christoph-krionx/UFC/README.md

# UFC – configurable MIDI foot controller

A MIDI foot controller for guitarists, built around an Arduino Mega 2560 Pro.
Every switch can send program changes and control changes to amps, modellers and effects.
The assignment is edited on the device itself or with a web editor over USB.

The same board and firmware are used in two builds:

| Variant | `BOARD` | Switches | LEDs | Display | Pages |
| --- | --- | --- | --- | --- | --- |
| UFC | `1` (default) | 21 foot switches, 4 external switches | 2 per switch | 20x2 LCD with edit mode | 1 |
| Stomp6 | `2` | 6 foot switches | 1 per switch | 20x2 LCD with the switch names, configured with the web editor | 2 (scenes, pedalboard) |

## Hardware

Board **UFC rev. 1** (KiCad 10 project in `hardware/UFC`, schematic as [PDF](hardware/UFC/UFC.pdf)):

- RobotDyn Mega 2560 Pro (ATmega2560, CH340 USB serial)
- 21 foot switches in four rows (3 + 6 + 6 + 6), each with two WS2812 LEDs
- 4 inputs for external switches, 2 inputs for expression pedals
- 20x2 character LCD (HD44780)
- 2 MIDI inputs and 2 MIDI outputs (5 pin DIN)

### Board revisions

| Revision | Date | Git tag | Notes |
| --- | --- | --- | --- |
| rev. 1 | 2026-10-12 | `hw-rev1` | LCD pin 5 (R/W) connected to GND |
| rev. 0 | 2018-10-05 | `hw-rev0` | manufactured, has a known error (see below) |

**Known error of rev. 0:** pin 5 (R/W) of the LCD is connected to +5 V instead of GND.
The display stays in read mode and shows nothing.
Rework for existing boards: cut the connection between pin 5 and +5 V at the display connector and connect pin 5 to GND, for example to pin 1.

The firmware runs on both revisions without changes.
The fabrication files of rev. 1 are in `hardware/UFC/Gerber`, those of rev. 0 in `hardware/UFC/Gerber/rev00`.

### Pin assignment

The firmware takes the mapping from `firmware/ufc/Board.h`.

| Function | Arduino pin | Connector | Notes |
| --- | --- | --- | --- |
| LCD RS / EN | D5 / D7 | DISP1 | 4 bit mode, R/W tied to GND (rev. 0: see board revisions) |
| LCD DB4 – DB7 | D9, D11, D13, D15 | DISP1 | contrast set with trimmer RV1 |
| LED data | D6 | J22 | WS2812 chain, 220 Ω in series |
| LED power enable | D12 | – | active low, switches the LED supply |
| MIDI 1 out / in | D18 (TX1) / D19 (RX1) | J23 / J25 | `Serial1`, input with optocoupler |
| MIDI 2 out / in | D16 (TX2) / D17 (RX2) | J24 / J26 | `Serial2`, input with optocoupler |
| Expression pedal 1 / 2 | A0 / A1 | J27 / J28 | AREF is driven externally, the firmware has to use `analogReference(EXTERNAL)` |
| External switch 1 / 2 | D21 / D22 | J29 | active low |
| External switch 3 / 4 | D23 / D24 | J30 | active low |
| USB serial (editor, upload) | D0 / D1 | USB | CH340 on the Mega 2560 Pro |
| Supply | VIN / 5V | J32 / J31 | |

Unused pins: D2, D3, D4, D8, D10, D14, D20, D25 – D32, A2 – A15.

### Foot switches and LEDs

The switches are numbered from bottom left to top right as seen by the player.
All switch inputs are active low with a 10 kΩ pull-up and 100 nF on the board.
The LED chain starts at switch 19 and snakes down row by row, the table shows the position of the left and right LED in the chain (0 – 41).

| Row | Switch | Arduino pin | Connector | LED left / right |
| --- | --- | --- | --- | --- |
| 4 (top) | 19 | D51 | J1 | 0 / 1 |
| | 20 | D49 | J2 | 2 / 3 |
| | 21 | D45 | J3 | 4 / 5 |
| 3 | 13 | D40 | J9 | 17 / 16 |
| | 14 | D37 | J8 | 15 / 14 |
| | 15 | D35 | J7 | 13 / 12 |
| | 16 | D33 | J6 | 11 / 10 |
| | 17 | D41 | J5 | 9 / 8 |
| | 18 | D44 | J4 | 7 / 6 |
| 2 | 7 | D39 | J10 | 18 / 19 |
| | 8 | D52 | J11 | 20 / 21 |
| | 9 | D50 | J12 | 22 / 23 |
| | 10 | D48 | J13 | 24 / 25 |
| | 11 | D47 | J14 | 26 / 27 |
| | 12 | D42 | J15 | 28 / 29 |
| 1 (bottom) | 1 | D53 | J21 | 41 / 40 |
| | 2 | D46 | J20 | 39 / 38 |
| | 3 | D43 | J19 | 37 / 36 |
| | 4 | D38 | J18 | 35 / 34 |
| | 5 | D36 | J17 | 33 / 32 |
| | 6 | D34 | J16 | 31 / 30 |

### Stomp6 variant

Six foot switches in two rows of three, one WS2812 LED per switch.
The 20x2 LCD (Fordata FC2002C, same connection as on the UFC) sits between the rows.
MIDI 1 has input and output, MIDI 2 only the output.
The mapping is in `firmware/ufc/Board_Stomp6.h`.
The LED chain starts at switch 3 (bottom right), runs to the left and back through the top row.

| Row | Switch | Arduino pin | Connector | LED |
| --- | --- | --- | --- | --- |
| top | 4 | D35 | J7 | 3 |
| | 5 | D33 | J6 | 4 |
| | 6 | D41 | J5 | 5 |
| bottom | 1 | D44 | J4 | 2 |
| | 2 | D45 | J3 | 1 |
| | 3 | D49 | J2 | 0 |

## Repository

| Folder | Content |
| --- | --- |
| `firmware/ufc` | controller firmware |
| `firmware/ufc_hwtest` | stand-alone hardware test |
| `editor` | web editor (plain HTML and JavaScript, no build step) |
| `hardware/UFC` | schematic, layout, project libraries and Gerber files |

## Firmware

Features of the current version:

- 8 presets with names, the last used preset is restored after power on
- up to 3 messages per switch (Stomp6: 5), program change or control change, each with MIDI output and channel
- switch modes: toggle, momentary and group (only one switch of the group on the same page is active)
- global switches which keep their function in every preset, for example preset up / down or tuner; on boards with pages a switch is global per page (Stomp6: a global pedalboard block, the scene at the same place stays per preset)
- messages which are sent when a preset is loaded
- pages: every preset has its own switch assignment per page (Stomp6: page 1 scenes, page 2 pedalboard)
- links: a switch sets the switches of the last page on or off when it is switched on, the LEDs follow (Stomp6: a scene sets the pedalboard blocks)
- actions: long press of a switch or two switches pressed together, for example tuner, preset up / down or page change; a switch with an action reacts on release
- Stomp6 display: line 1 shows the names of the top row, line 2 the names of the bottom row, each name above / below its switch; the names follow the page.
  Preset number, name and tempo, the page name and the tap tempo are shown in line 1 for 1.5 s, the name of an active MIDI action (for example `TUNER`) replaces line 1 while the action is on
  If the top left and the top middle switch have no function or no name, line 1 keeps showing preset number and name (with the tempo if the top right switch is free too)
- optional pause after a program change, optionally a program change is only sent if it differs from the last one on the channel
- MIDI clock with a tempo per preset (0: no clock until tapped), tap tempo on a switch with the function "Tap" or on the active group switch pressed again, the tap switch flashes in time
- configuration stored in the internal EEPROM, every block protected by a checksum; a configuration of the other variant or an older format is replaced by the factory configuration

### Build and upload

The firmware is a plain Arduino sketch. Required libraries: FastLED and LiquidCrystal.

```bash
arduino-cli compile --fqbn arduino:avr:mega firmware/ufc
```

```bash
arduino-cli upload --fqbn arduino:avr:mega -p <port> firmware/ufc
```

The Stomp6 variant is selected with `BOARD=2`, compile and upload in one step:

```bash
arduino-cli compile --fqbn arduino:avr:mega --build-property "build.extra_flags=-DBOARD=2" --upload -p <port> firmware/ufc
```

The Arduino IDE works as well: open `firmware/ufc/ufc.ino` and select the board "Arduino Mega or Mega 2560".
For the Stomp6 variant change the default of `BOARD` in `firmware/ufc/Board.h`.

### Stomp6 with a Sonulab StompStation PRO

The factory configuration of the Stomp6 variant is made for the StompStation PRO on MIDI channel 1 (StompStation: Setting, Misc, MIDI Address 0).
The StompStation has a 3.5 mm TRS jack, the MIDI cable needs a **Type A** adapter.

| Gesture | Function |
| --- | --- |
| switch 1 – 6 | scene (page 1) or block on / off (page 2) |
| active scene again | tap tempo, the scene flashes in time while the MIDI clock runs |
| hold switch 1 | tuner on / off (CC 11), switch 1 lights red while it is on |
| hold switch 6 | change between scenes and pedalboard |
| switch 1 + 2 | previous preset |
| switch 2 + 3 | next preset |

All presets are empty, the scenes are assigned in the editor.
The pedalboard is global with Drive (CC 1), Comp (CC 8), Wah (CC 14), Mod post (CC 6), Delay (CC 10) and Reverb (CC 5).
The actions above and tap tempo on the active scene are part of the factory configuration.
Delay and modulation of the StompStation follow the MIDI clock if they are locked to the global tempo.

A setup used with the StompStation: presets 1 – 6 are one main sound each, the start message of the preset sends PC 0 – 5.
The scenes (for example rhythm, solo, clean) send the same program change and set all six pedalboard blocks, so the LEDs always show the real state.
Useful fixed control changes of the StompStation:

| CC | Block | CC | Block |
| --- | --- | --- | --- |
| 1 | Drive | 9 | Gate |
| 2 | Mod pre | 10 | Delay 1 |
| 3 | Amp | 11 | Tuner |
| 4 | IR | 12 | Expr |
| 5 | Reverb | 13 | Expr Boost |
| 6 | Mod post | 14 | Wah |
| 7 | Tremolo | 15 | EQ |
| 8 | Comp | 16 | Pitch |

Values 0 – 63 switch a block off, 64 – 127 on. CC 20 is the global volume, CC 21 / 22 select the next / previous preset.
Other parameters are reached with the assignable controllers 1 – 3 of the StompStation (CC 32 – 127).

Tested behaviour of the StompStation (firmware of October 2026):

- a program change switches presets without asking, unsaved changes of the active preset are discarded
- a control change sent directly after a program change is applied
- the program change of the active preset loads it again, switching within a bank of three is gapless
- CC 21 / 22 select the next / previous preset (the troubleshooting chapter of the manual names CC 12 / 13 by mistake)
- the StompStation sends no state, the controller cannot know changes made on the pedal itself

### Edit mode on the device

Hold switch 19 and 20 (top row) for one second. The bottom row then works as keys:

| Switch | Function |
| --- | --- |
| 1 / 2 | previous / next field |
| 3 / 4 | value down / up, hold to repeat |
| 5 | back, unsaved changes are discarded |
| 6 | save |

Stepping on any other switch selects it for editing.

Holding switch 19 and 21 during power on restores the factory configuration (Stomp6: switch 4 and 6).
The Stomp6 variant has no edit mode.

## Web editor

The editor talks to the controller with the Web Serial API and therefore needs Chrome or Edge on a desktop computer.

```bash
python -m http.server 8137 --bind 127.0.0.1 --directory editor
```

Open `http://localhost:8137`, connect and select the serial port of the controller.
The configuration can also be saved to and loaded from a file.
The editor adapts to the connected variant, pages are selected above the switches, actions and the program change options are under "Global".
Files of older firmware versions (0.3 and later) can be loaded: values the file does not have are taken from the connected device or set to defaults, a switch that was global keeps its global definition on every page, actions get an empty name.
A file of the other variant (different number of switches) is rejected.

The serial protocol is described in `firmware/ufc/Protocol.h`, the data format in `firmware/ufc/Config.h` and `firmware/ufc/Storage.h`.

## Hardware test

`firmware/ufc_hwtest` checks display, LEDs, switches and both MIDI ports and shows the result on the display.
The MIDI test needs a DIN cable from each output to an input.

## License

MIT, see [LICENSE](LICENSE).
