christoph-krionx/UFC/hardware/UFC/UFC.pdf

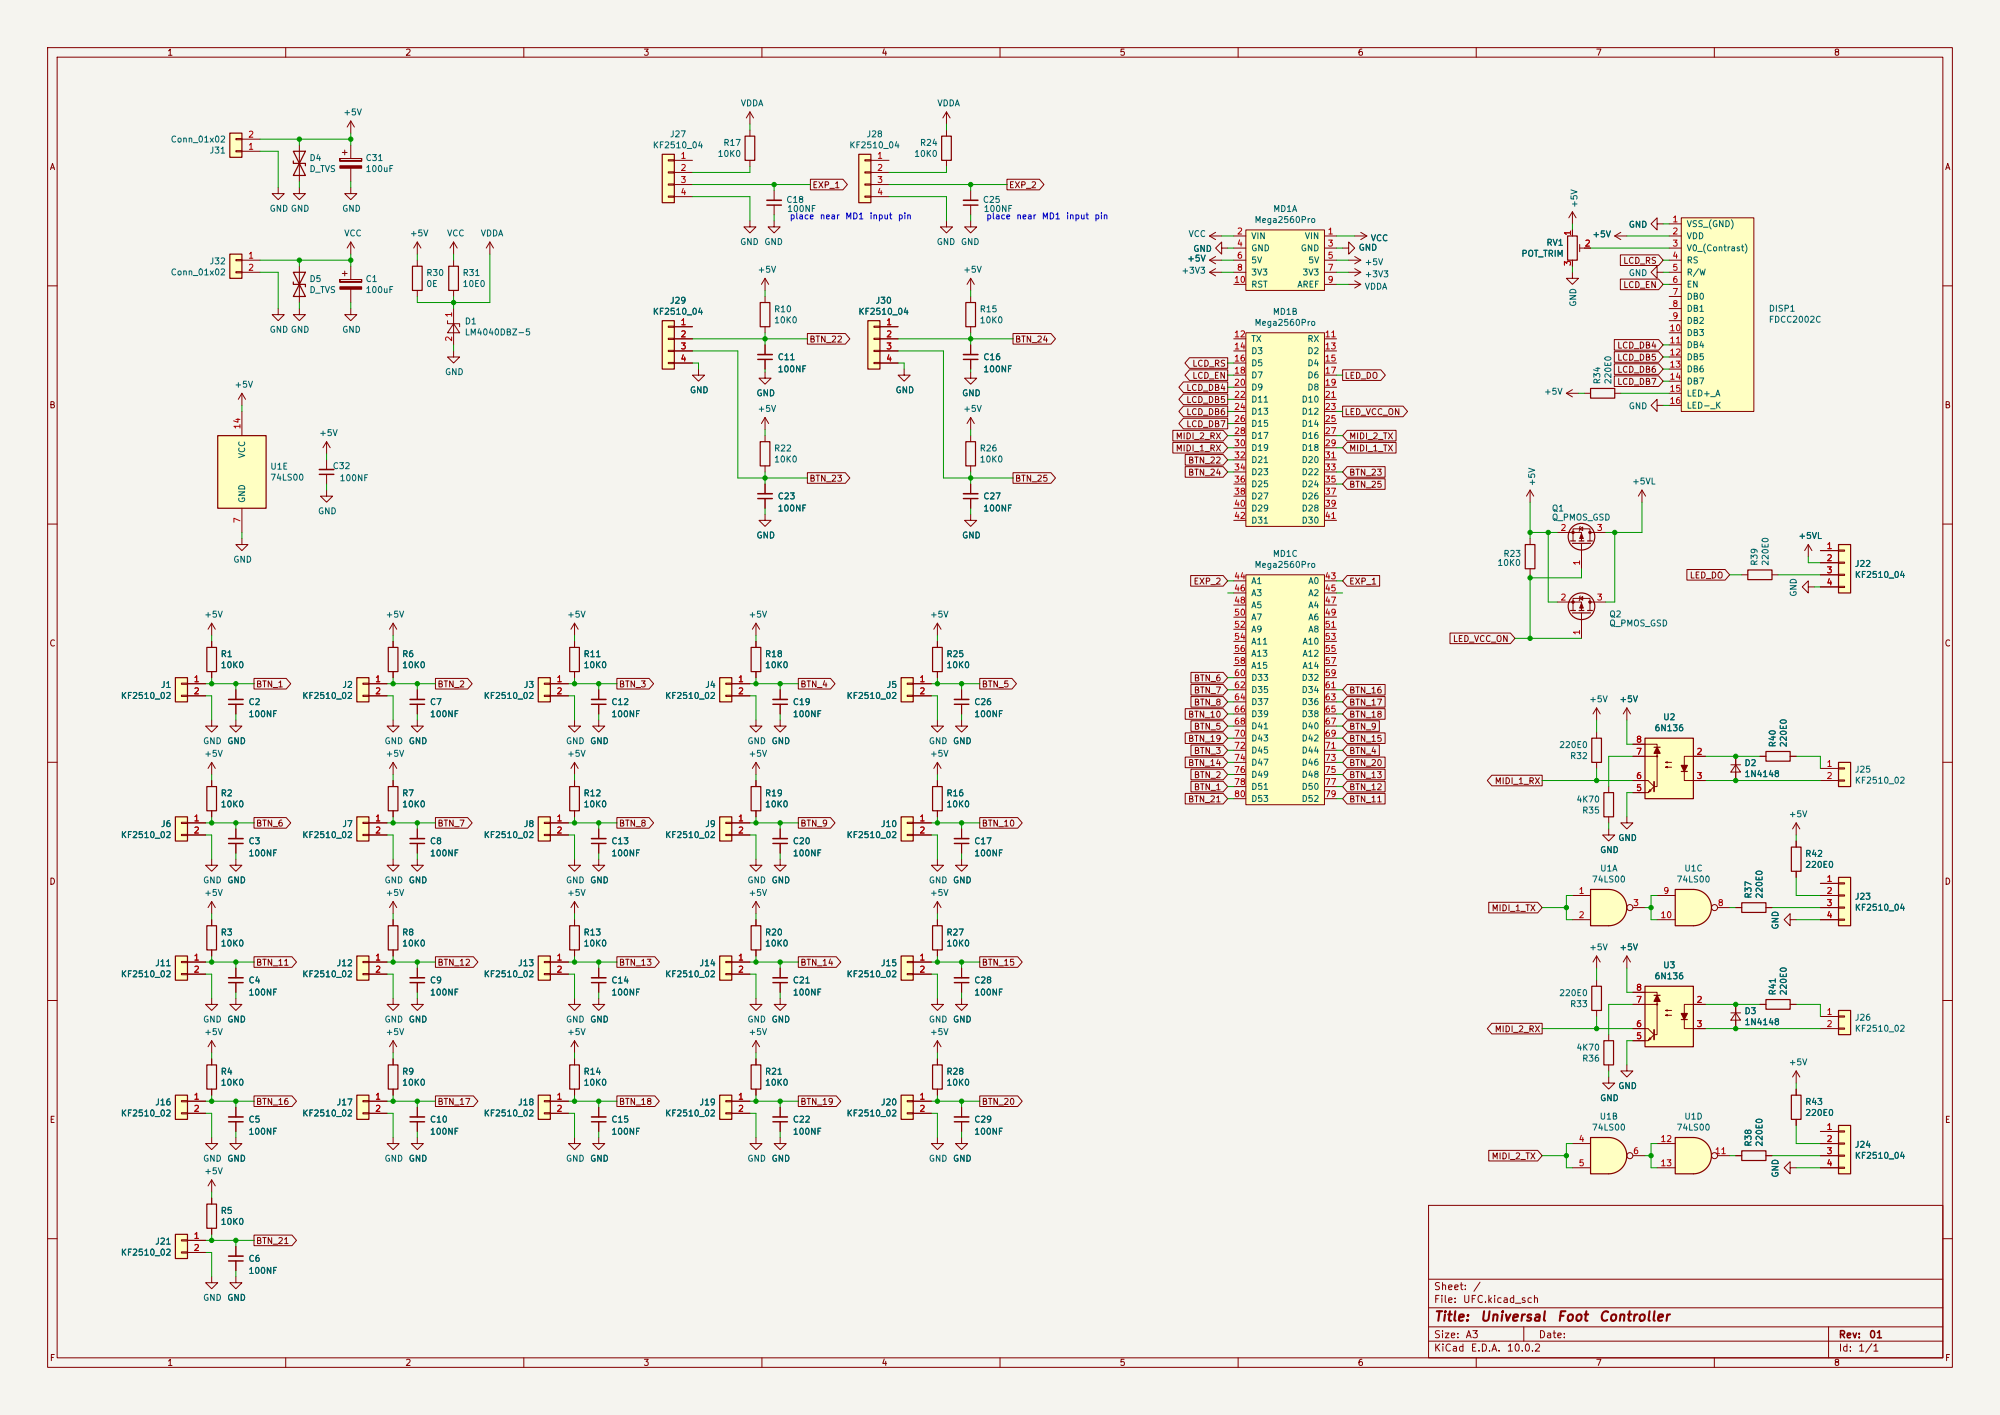
[picture p1: page 1]

Sheet: /
File: UFC.kicad_sch
Title: Universal Foot Controller

Size: A3 | Rev: 01 | F Date:
KiCad E.D.A. 10.0.2 | Id: 1/1
