christoph-krionx/UFC/hardware/UFC/UFC.kicad_pcb

## KiCad design hardware/UFC/UFC.kicad_pcb (2026-10-12)

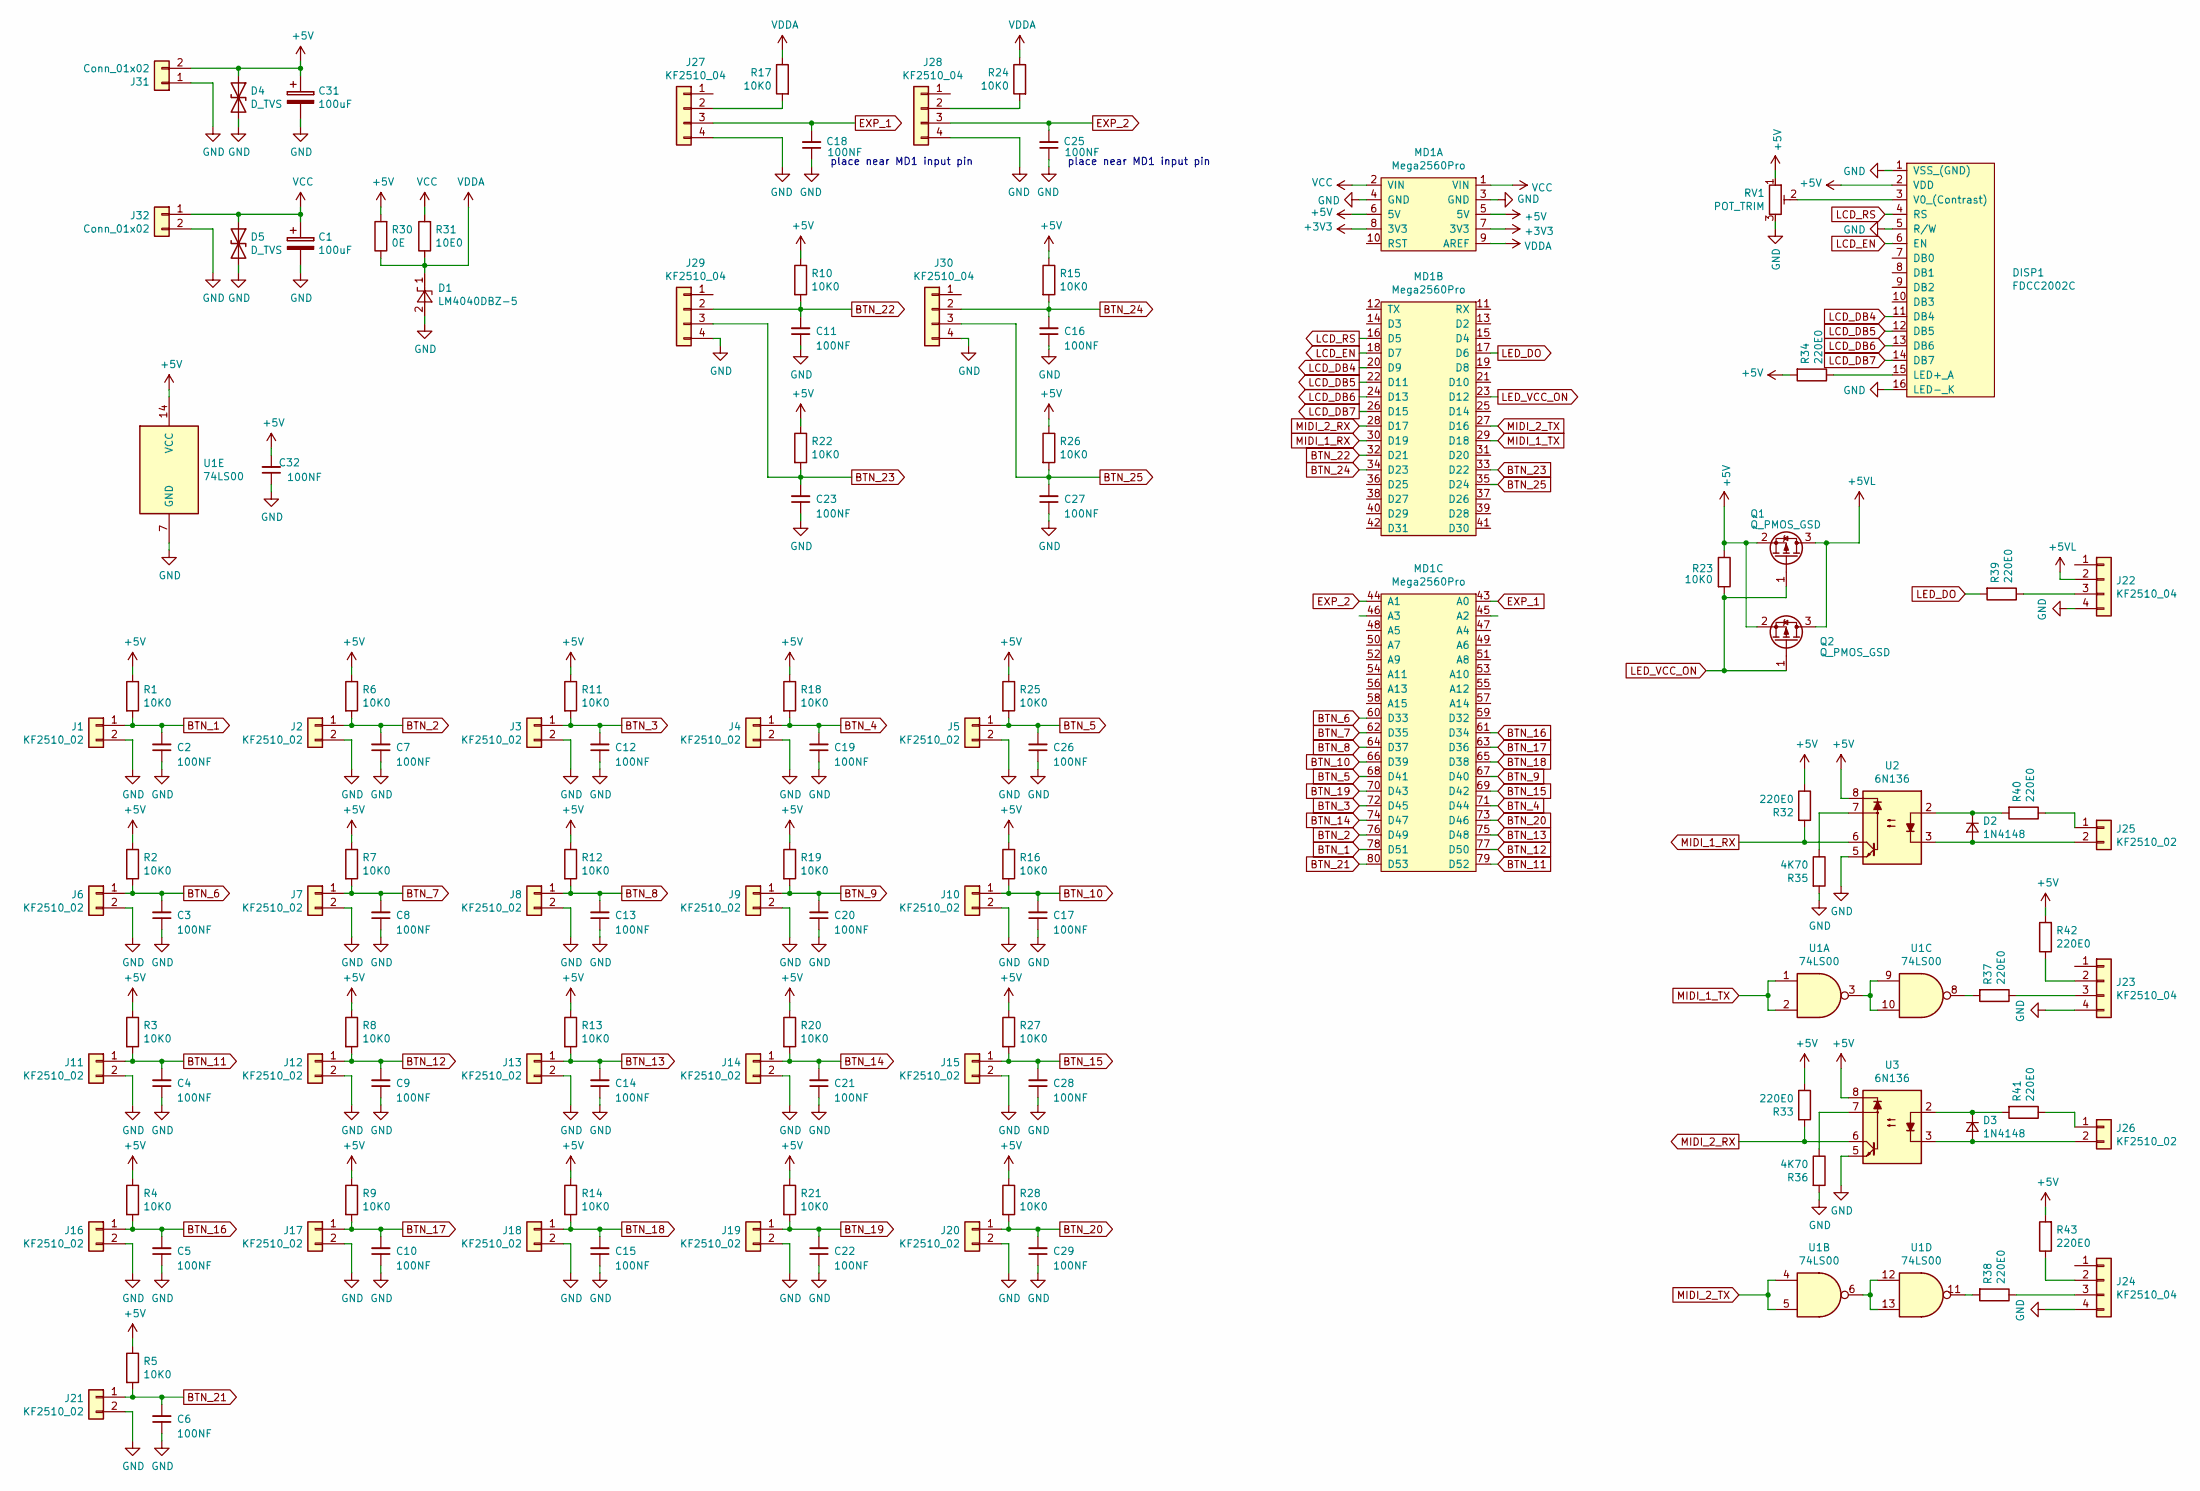
[picture p2: schematic UFC.kicad_sch, Universal Foot Controller]

Parts:
C1, C31: 100uF; CP_Radial_D10.0mm_P5.00mm
C2, C3, C4, C5, C6, C7, C8, C9, C10, C11, C12, C13, C14, C15, C16, C17, C18, C19, C20, C21, C22, C23, C25, C26, C27, C28, C29, C32: 100NF; C_0805_2012Metric_Pad1.29x1.40mm_HandSolder
D1: LM4040DBZ-5; SOT-23
D2, D3: 1N4148; D_DO-41_SOD81_P7.62mm_Horizontal
D4, D5: D_TVS; D_SMA_Handsoldering
DISP1: FDCC2002C
J1, J2, J3, J4, J5, J6, J7, J8, J9, J10, J11, J12, J13, J14, J15, J16, J17, J18, J19, J20, J21, J25, J26: KF2510_02; Molex_KK-254_AE-6410-02A_1x02_P2.54mm_Vertical
J22, J23, J24, J27, J28, J29, J30: KF2510_04; Molex_KK-254_AE-6410-04A_1x04_P2.54mm_Vertical
J31, J32: Conn_01x02; TerminalBlock_Phoenix_PT-1,5-2-3.5-H_1x02_P3.50mm_Horizontal
MD1: Mega2560Pro; Mega2560Core
Q1, Q2: Q_PMOS_GSD; SOT-23_Handsoldering
R1, R2, R3, R4, R5, R6, R7, R8, R9, R10, R11, R12, R13, R14, R15, R16, R17, R18, R19, R20, R21, R22, R23, R24, R25, R26, R27, R28: 10K0; R_0805_2012Metric_Pad1.29x1.40mm_HandSolder
R30: 0E; R_0805_2012Metric_Pad1.29x1.40mm_HandSolder
R31: 10E0; R_0805_2012Metric_Pad1.29x1.40mm_HandSolder
R32, R33, R37, R38, R39, R40, R41, R42, R43: 220E0; R_0805_2012Metric_Pad1.29x1.40mm_HandSolder
R34: 220E0; R_1206_3216Metric_Pad1.39x1.80mm_HandSolder
R35, R36: 4K70; R_0805_2012Metric_Pad1.29x1.40mm_HandSolder
RV1: POT_TRIM; Potentiometer_Trimmer_Vishay_TS53YJ
U1: 74LS00; DIP-14_W7.62mm
U2, U3: 6N136; SMD-8

Connections:
+3V3: MD1.7 (3V3), MD1.8 (3V3)
+5V: C31.1, C32.2, D4.1 (A1), DISP1.2 (VDD), J31.2, MD1.5 (5V), MD1.6 (5V), Q1.2 (S), Q2.2 (S), R1.1, R2.1, R3.1, R4.1, R5.1, R6.1, R7.1, R8.1, R9.1, R10.1, R11.1, R12.1, R13.1, R14.1, R15.1, R16.1, R18.1, R19.1, R20.1, R21.1, R22.1, R23.1, R25.1, R26.1, R27.1, R28.1, R30.2, R32.1, R33.1, R34.2, R42.2, R43.2, RV1.1, U1.14 (VCC), U2.8, U3.8
+5VL: J22.2, Q1.3 (D), Q2.3 (D)
BTN_1: C2.2, J1.1, MD1.78 (D51), R1.2
BTN_2: C7.2, J2.1, MD1.76 (D49), R6.2
BTN_3: C12.2, J3.1, MD1.72 (D45), R11.2
BTN_4: C19.2, J4.1, MD1.71 (D44), R18.2
BTN_5: C26.2, J5.1, MD1.68 (D41), R25.2
BTN_6: C3.2, J6.1, MD1.60 (D33), R2.2
BTN_7: C8.2, J7.1, MD1.62 (D35), R7.2
BTN_8: C13.2, J8.1, MD1.64 (D37), R12.2
BTN_9: C20.2, J9.1, MD1.67 (D40), R19.2
BTN_10: C17.2, J10.1, MD1.66 (D39), R16.2
BTN_11: C4.2, J11.1, MD1.79 (D52), R3.2
BTN_12: C9.2, J12.1, MD1.77 (D50), R8.2
BTN_13: C14.2, J13.1, MD1.75 (D48), R13.2
BTN_14: C21.2, J14.1, MD1.74 (D47), R20.2
BTN_15: C28.2, J15.1, MD1.69 (D42), R27.2
BTN_16: C5.2, J16.1, MD1.61 (D34), R4.2
BTN_17: C10.2, J17.1, MD1.63 (D36), R9.2
BTN_18: C15.2, J18.1, MD1.65 (D38), R14.2
BTN_19: C22.2, J19.1, MD1.70 (D43), R21.2
BTN_20: C29.2, J20.1, MD1.73 (D46), R28.2
BTN_21: C6.2, J21.1, MD1.80 (D53), R5.2
BTN_22: C11.2, J29.2, MD1.32 (D21), R10.2
BTN_23: C23.2, J29.3, MD1.33 (D22), R22.2
BTN_24: C16.2, J30.2, MD1.34 (D23), R15.2
BTN_25: C27.2, J30.3, MD1.35 (D24), R26.2
EXP_1: C18.2, J27.3, MD1.43 (A0)
EXP_2: C25.2, J28.3, MD1.44 (A1)
GND: C1.2, C2.1, C3.1, C4.1, C5.1, C6.1, C7.1, C8.1, C9.1, C10.1, C11.1, C12.1, C13.1, C14.1, C15.1, C16.1, C17.1, C18.1, C19.1, C20.1, C21.1, C22.1, C23.1, C25.1, C26.1, C27.1, C28.1, C29.1, C31.2, C32.1, D1.2 (A), D4.2 (A2), D5.2 (A2), DISP1.1 (VSS_(GND)), DISP1.5 (R/W), DISP1.16 (LED-_K), J1.2, J2.2, J3.2, J4.2, J5.2, J6.2, J7.2, J8.2, J9.2, J10.2, J11.2, J12.2, J13.2, J14.2, J15.2, J16.2, J17.2, J18.2, J19.2, J20.2, J21.2, J22.4, J23.4, J24.4, J27.4, J28.4, J29.4, J30.4, J31.1, J32.2, MD1.3 (GND), MD1.4 (GND), R35.2, R36.2, RV1.3, U1.7 (GND), U2.5, U3.5
LCD_DB4: DISP1.11 (DB4), MD1.20 (D9)
LCD_DB5: DISP1.12 (DB5), MD1.22 (D11)
LCD_DB6: DISP1.13 (DB6), MD1.24 (D13)
LCD_DB7: DISP1.14 (DB7), MD1.26 (D15)
LCD_EN: DISP1.6 (EN), MD1.18 (D7)
LCD_RS: DISP1.4 (RS), MD1.16 (D5)
LED_DO: MD1.17 (D6), R39.2
LED_VCC_ON: MD1.23 (D12), Q1.1 (G), Q2.1 (G), R23.2
MIDI_1_RX: MD1.30 (D19), R32.2, U2.6
MIDI_1_TX: MD1.29 (D18), U1.1, U1.2
MIDI_2_RX: MD1.28 (D17), R33.2, U3.6
MIDI_2_TX: MD1.27 (D16), U1.4, U1.5
unnamed: D2.2 (A), J25.2, U2.3
unnamed: D2.1 (K), R40.2, U2.2
unnamed: D3.2 (A), J26.2, U3.3
unnamed: D3.1 (K), R41.2, U3.2
unnamed: DISP1.15 (LED+_A), R34.1
unnamed: DISP1.3 (V0_(Contrast)), RV1.2
unnamed: J22.3, R39.1
unnamed: J23.2, R42.1
unnamed: J23.3, R37.1
unnamed: J24.2, R43.1
unnamed: J24.3, R38.1
unnamed: J25.1, R40.1
unnamed: J26.1, R41.1
unnamed: J27.2, R17.2
unnamed: J28.2, R24.2
unnamed: R35.1, U2.7
unnamed: R36.1, U3.7
unnamed: R37.2, U1.8
unnamed: R38.2, U1.11
unnamed: U1.3, U1.9, U1.10
unnamed: U1.6, U1.12, U1.13
VCC: C1.1, D5.1 (A1), J32.1, MD1.1 (VIN), MD1.2 (VIN), R31.2
VDDA: D1.1 (K), MD1.9 (AREF), R17.1, R24.1, R30.1, R31.1

Notes on the sheet:
place near MD1 input pin

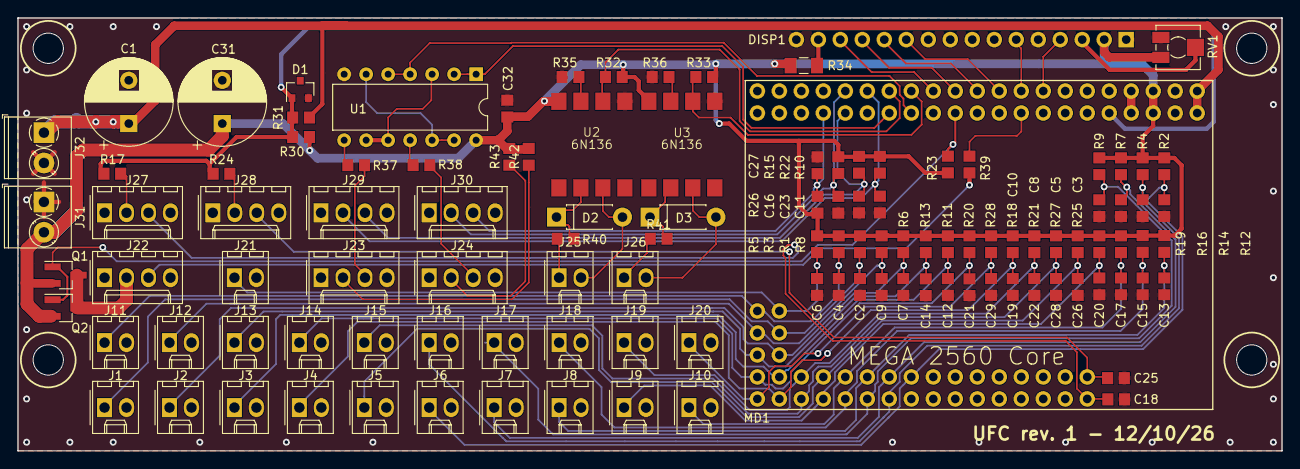
[picture p3: board UFC.kicad_pcb from above]

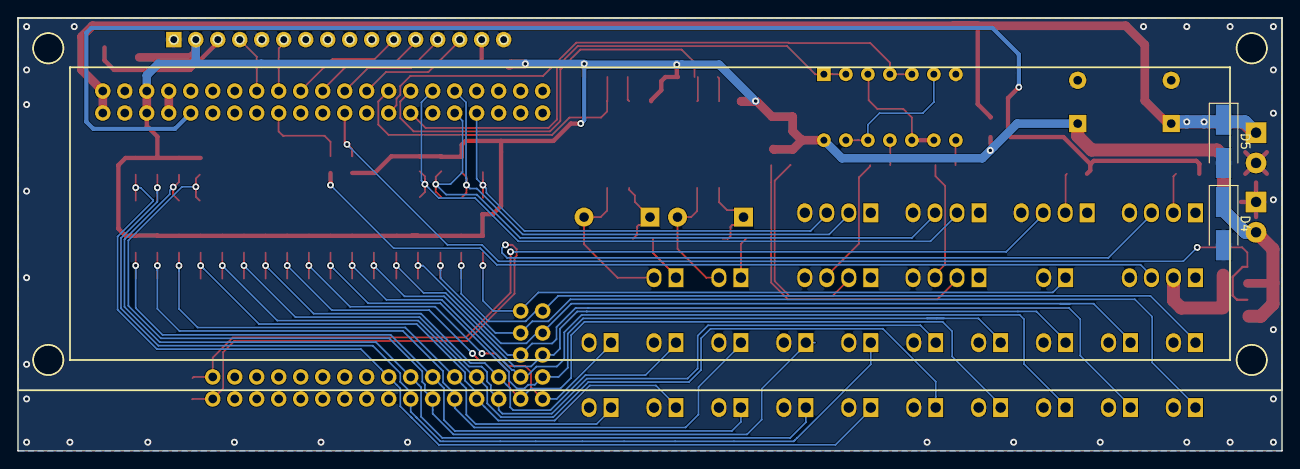
[picture p4: board UFC.kicad_pcb from below]

Board: 2 copper layers, 146.0 x 50.0 mm, 117 parts (2 on the bottom side), 66 nets.
