christoph-krionx/UFC/(commit log)

2026-10-11 Initial commit: UFC configurable MIDI foot controller
    Firmware, hardware test and web editor for the UFC rev. 0 board.
2026-10-11 Document the pin assignment in the README
2026-10-11 Add the KiCad project of the UFC rev. 0 board
    Schematic, layout and Gerber files. All symbols and footprints are kept in
    project libraries, so the project does not depend on the installed KiCad libraries.
    [UFC-B.Cu.gbl, UFC-B.Fab.gbr, UFC-B.Mask.gbs, UFC-Edge.Cuts.gm1, UFC-F.Cu.gtl, UFC-F.Fab.gbr, UFC-F.Mask.gts, UFC-NPTH-drl_map.gbr]
2026-10-12 Board rev. 1: connect LCD pin 5 (R/W) to GND
    On rev. 0 the pin was connected to +5V, the display stayed in read mode.
    The fabrication files of rev. 0 are kept in Gerber/rev00, the README lists
    the revisions and the rework for existing boards.
    [UFC-B.Cu.gbl, UFC-B.Fab.gbr, UFC-B.Mask.gbs, UFC-B_Cu.gbl, UFC-B_Mask.gbs, UFC-B_Paste.gbp, UFC-B_Silkscreen.gbo, UFC-Edge.Cuts.gm1]
2026-10-31 Firmware 0.4.0: Stomp6 board variant, pages, scenes and actions
    The UFC board is also used with only 6 foot switches, one LED each and
    no display. The variant is selected at compile time with BOARD=2.
    - board definitions split into Board_UFC21.h and Board_Stomp6.h
    - pages: a preset has its own switch assignment per page
    - links: a switch sets the switches of the last page on / off (scenes
    set the pedalboard blocks)
    - actions: long press or two switches together, e.g. tuner, preset
    up / down, page change
    - optional pause after a program change and option to skip a program
    change equal to the last one
    - debounce accepts a switch state only after it is stable for 20 ms,
    a bouncing rele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
    [Board.h, Board_Stomp6.h, Board_UFC21.h, Config.h, Controller.cpp, Controller.h, Display.cpp, Display.h]
2026-11-01 Firmware 0.5.0: tap tempo and MIDI clock
    - tempo per preset, the controller sends MIDI clock (24 ticks per
    quarter note) while a tempo is set or after tapping
    - tap tempo on a switch with the new function "Tap" or by pressing the
    active group switch (scene) again; the first press after loading a
    preset still sends the scene
    - the tap switch flashes in time while the clock runs
    - global options: tap on the active group switch, clock outputs
    - Stomp6 factory configuration taps on the active scene
    - storage version 3, protocol version 3
    - editor: tempo per preset, tap and clock settings under "Global"
2026-11-01 Firmware 0.6.0: global switches per page, import of old files
    - a switch is global per page: a global pedalboard block no longer
    replaces the scene at the same place
    - Stomp6 factory configuration: empty presets, global pedalboard with
    six StompStation blocks, actions and tap tempo as before
    - editor loads configuration files of all earlier versions, missing
    values come from the connected device or defaults
    - editor: writes to the serial port never overlap (a fast answer could
    start the next command while the port was still locked)
    - the LED chain is written again 150 ms and 600 ms after a change; on
    the Stomp6 the top row sometimes missed the update after a preset
    change with th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
    [Config.h, Controller.cpp, Controller.h, Factory.cpp, Leds.cpp, Leds.h, Menu.cpp, Protocol.cpp]
2026-11-04 Firmware 0.7.0: display on the Stomp6
    - the Stomp6 has the 20x2 LCD between the switch rows: line 1 shows the
    names of the top row, line 2 the names of the bottom row, each name
    at its switch, the names follow the page
    - preset number, name and tempo, page name and tap tempo are shown in
    line 1 for 1.5 s, an active MIDI action (tuner) shows its name there
    - if the top left and middle switch have no function or no name, line 1
    keeps showing the preset (with the tempo if the top right is free too)
    - actions have a name, the Stomp6 tuner action is called TUNER
    - HAS_MENU separates the edit mode from HAS_DISPLAY, the LCD pins are
    shared in Board.h
    - editor: name field for actions, file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
